jrjennings/LineMaze/LineMaze_schematic.pdf

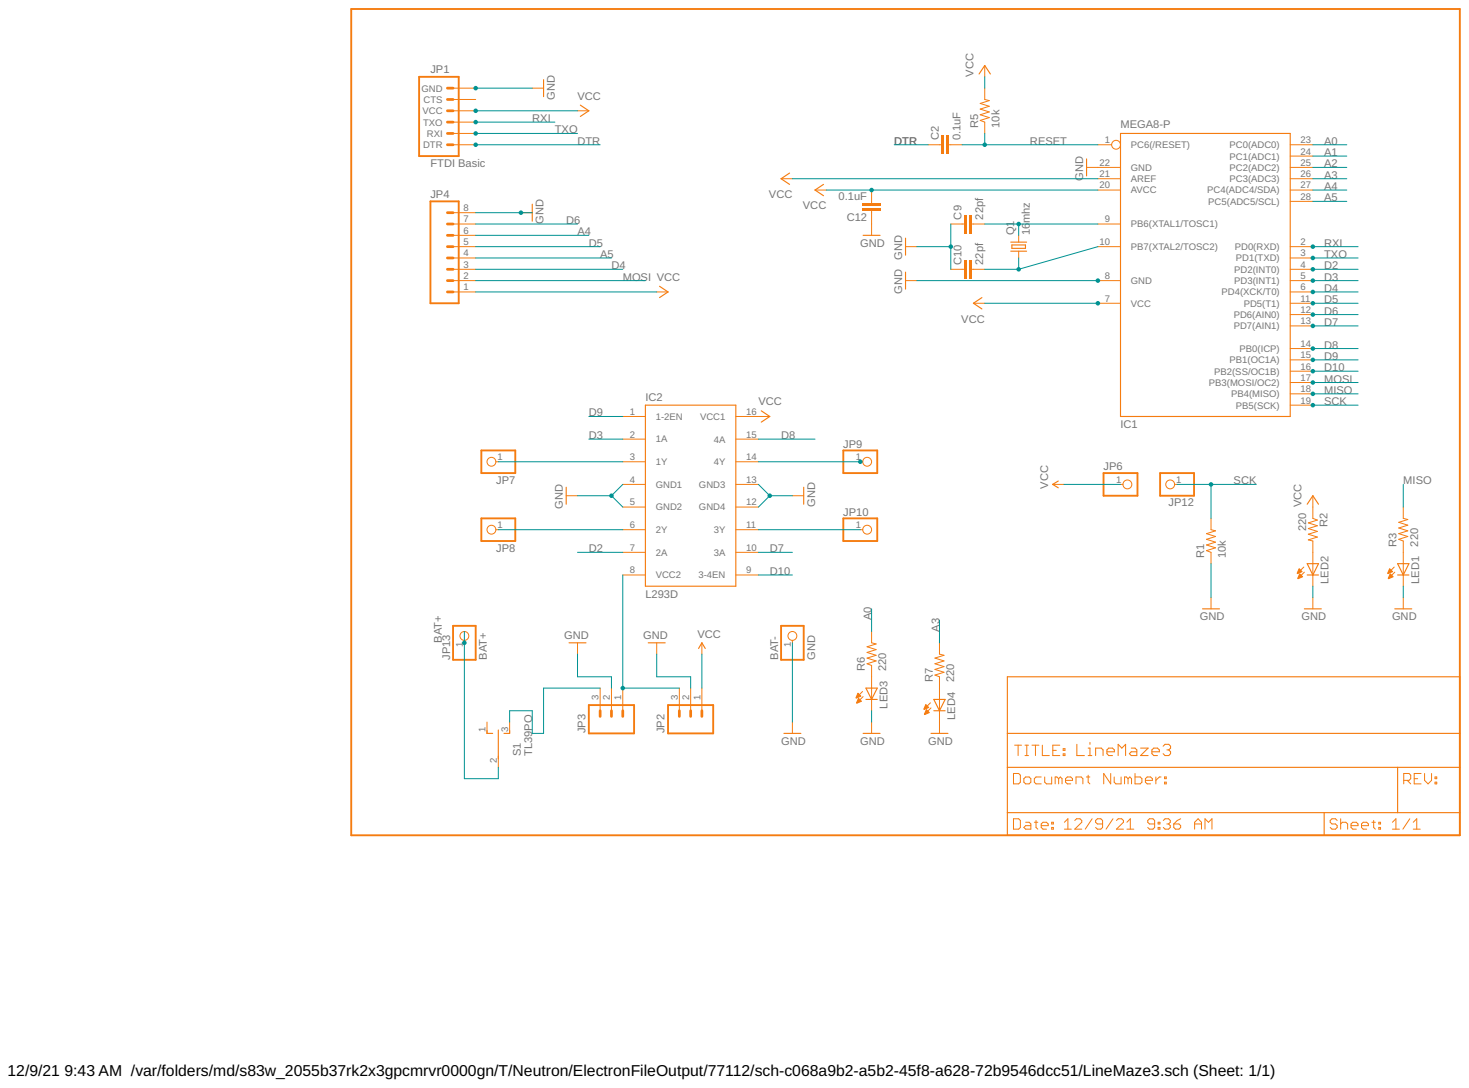
[picture p3: page 1]

12/9/21 9:43 AM /var/folders/md/s83w_2055b37rk2x3gpcmrvr0000gn/T/Neutron/ElectronFileOutput/77112/sch-c068a9b2-a5b2-45f8-a628-72b9546dcc51/LineMaze3.sch (Sheet: 1/1)
